gorry/RetroVGen/README.md

# RetroVGen
Retro RGB Video Signal Generator

RetroVGenは、Arduino Unoを使用してレトロPCのRGBビデオ出力を模倣した信号を生成します。

RetroVGen generate a signal that mimics Retro-PC RGB video output using Arduino Uno.

Refer to : http://gorry.haun.org/pw/?RetroVGen
