gorry/RetroVGen/RetroVGen/circuit/01-shield.png

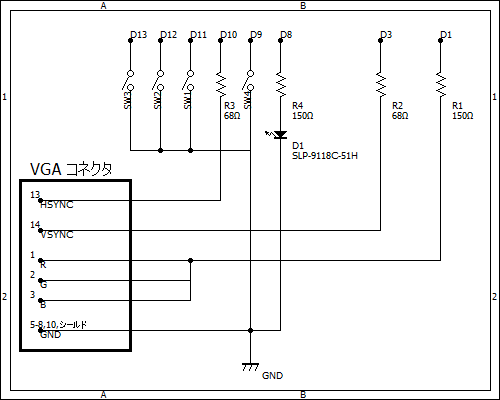
RetroVGen/circuit/01-shield.png
