gorry/RetroVGen/RetroVGen/circuit/02-avr.png

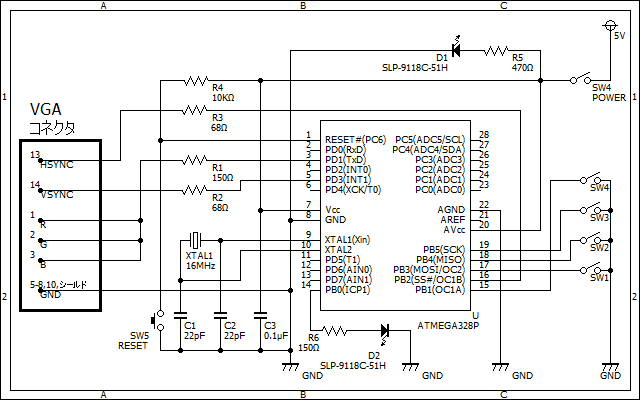
RetroVGen/circuit/02-avr.png
