gorry/RetroVGen/RetroVGen/original.h

// ============
//   ORIGINAL
// ============

/*
 VGA video generation
 
 Author:   Nick Gammon
 Date:     20th April 2012
 Version:  1.2
 
 Version 1.0: initial release
 Version 1.1: code cleanups
 Version 1.2: more cleanups, added clear screen (0x0C), added scrolling
 

 PERMISSION TO DISTRIBUTE
 
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
 
 LIMITATION OF LIABILITY
 
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
*/
