gorry/RetroVGen/(commit log)

2019-01-25 最初のコミット
2019-01-25 日本語説明を追加
2019-01-25 UTF-8化
2019-01-25 X68000 15kHzの横方向文字出力を少し広げる
2019-01-31 ・回路図のHSYNC/VSYNCが入れ違いになっていたのを修正。 ・単体版回路図のPB0がGNDに繋がってしまっていたのを外す。 ・readmeに「制限事項」の項目を追加。
2019-01-31 更新忘れ
2019-10-26 VSYNCで増えるカウンタを画面に表示するようにした。
2020-03-22 20200322a
    ・ATMEGA328P Pin14（PB0/ICP1、シールドD8）をLEDに結線。
    ・VSYNCカウンタ0～3の間、LEDを点灯するようにした。
2023-01-05 20230105a
    ・最新のArduino環境で正しく表示できない問題を修正。
    ・表示が中央寄りになるよう改善。
    ・HEXバイナリを配布ファイルに追加（guidudeでの書き込みを確認）
    [RetroVGen.ino, videoparam.h]
